DimitrisKopsidas/3D_Printed_WiFi_Amplifier/base.stl

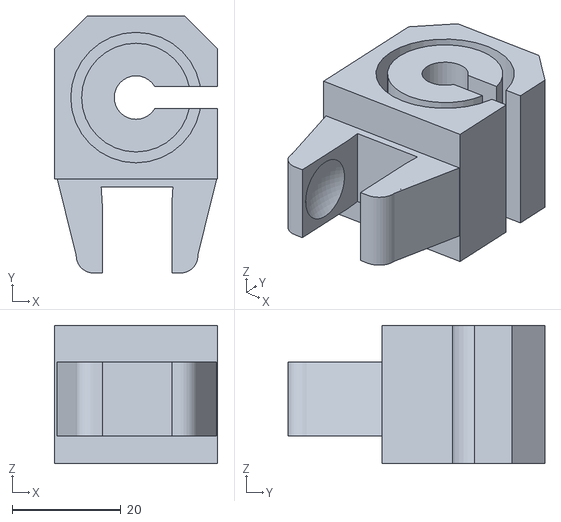
[picture p4: CAD file, 2024-10-04]
base.stl
30.0 x 47.3 x 25.5
