DimitrisKopsidas/3D_Printed_WiFi_Amplifier/antenna.stl

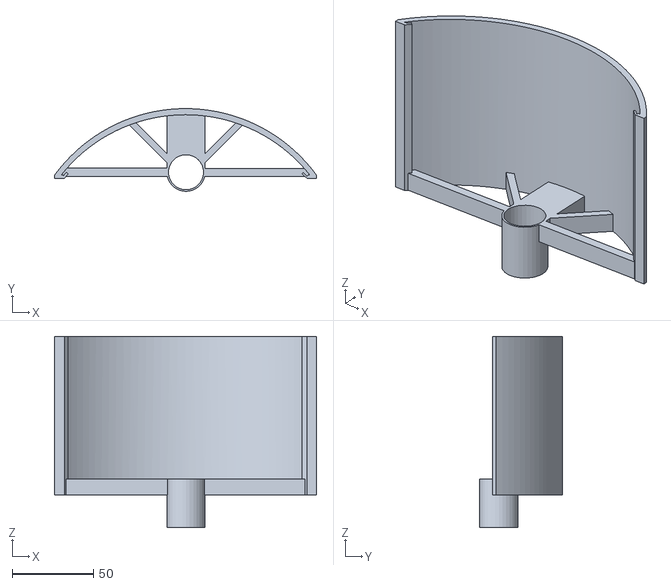
[picture p5: CAD file, 2024-10-04]
antenna.stl
161.2 x 51.0 x 117.8
