DimitrisKopsidas/3D_Printed_WiFi_Amplifier/clip.stl

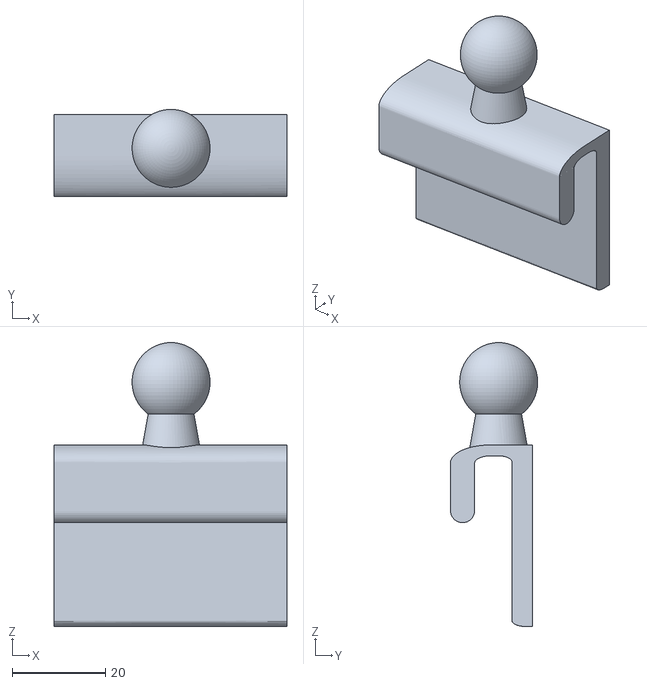
[picture p6: CAD file, 2024-10-04]
clip.stl
50.0 x 18.7 x 61.0
